ravotus/FaucetLED-pcb/README.md

# FaucetLED-pcb
PCB for the [FaucetLED](https://github.com/ravotus/FaucetLED) project.

Created with KiCad 4.0.5. Available through OSHPark: [https://oshpark.com/shared_projects/xyDQwA8Q](https://oshpark.com/shared_projects/xyDQwA8Q)
