ravotus/FaucetLED-pcb/FaucetLED.kicad_pcb

## KiCad design FaucetLED.kicad_pcb (2017-04-03)

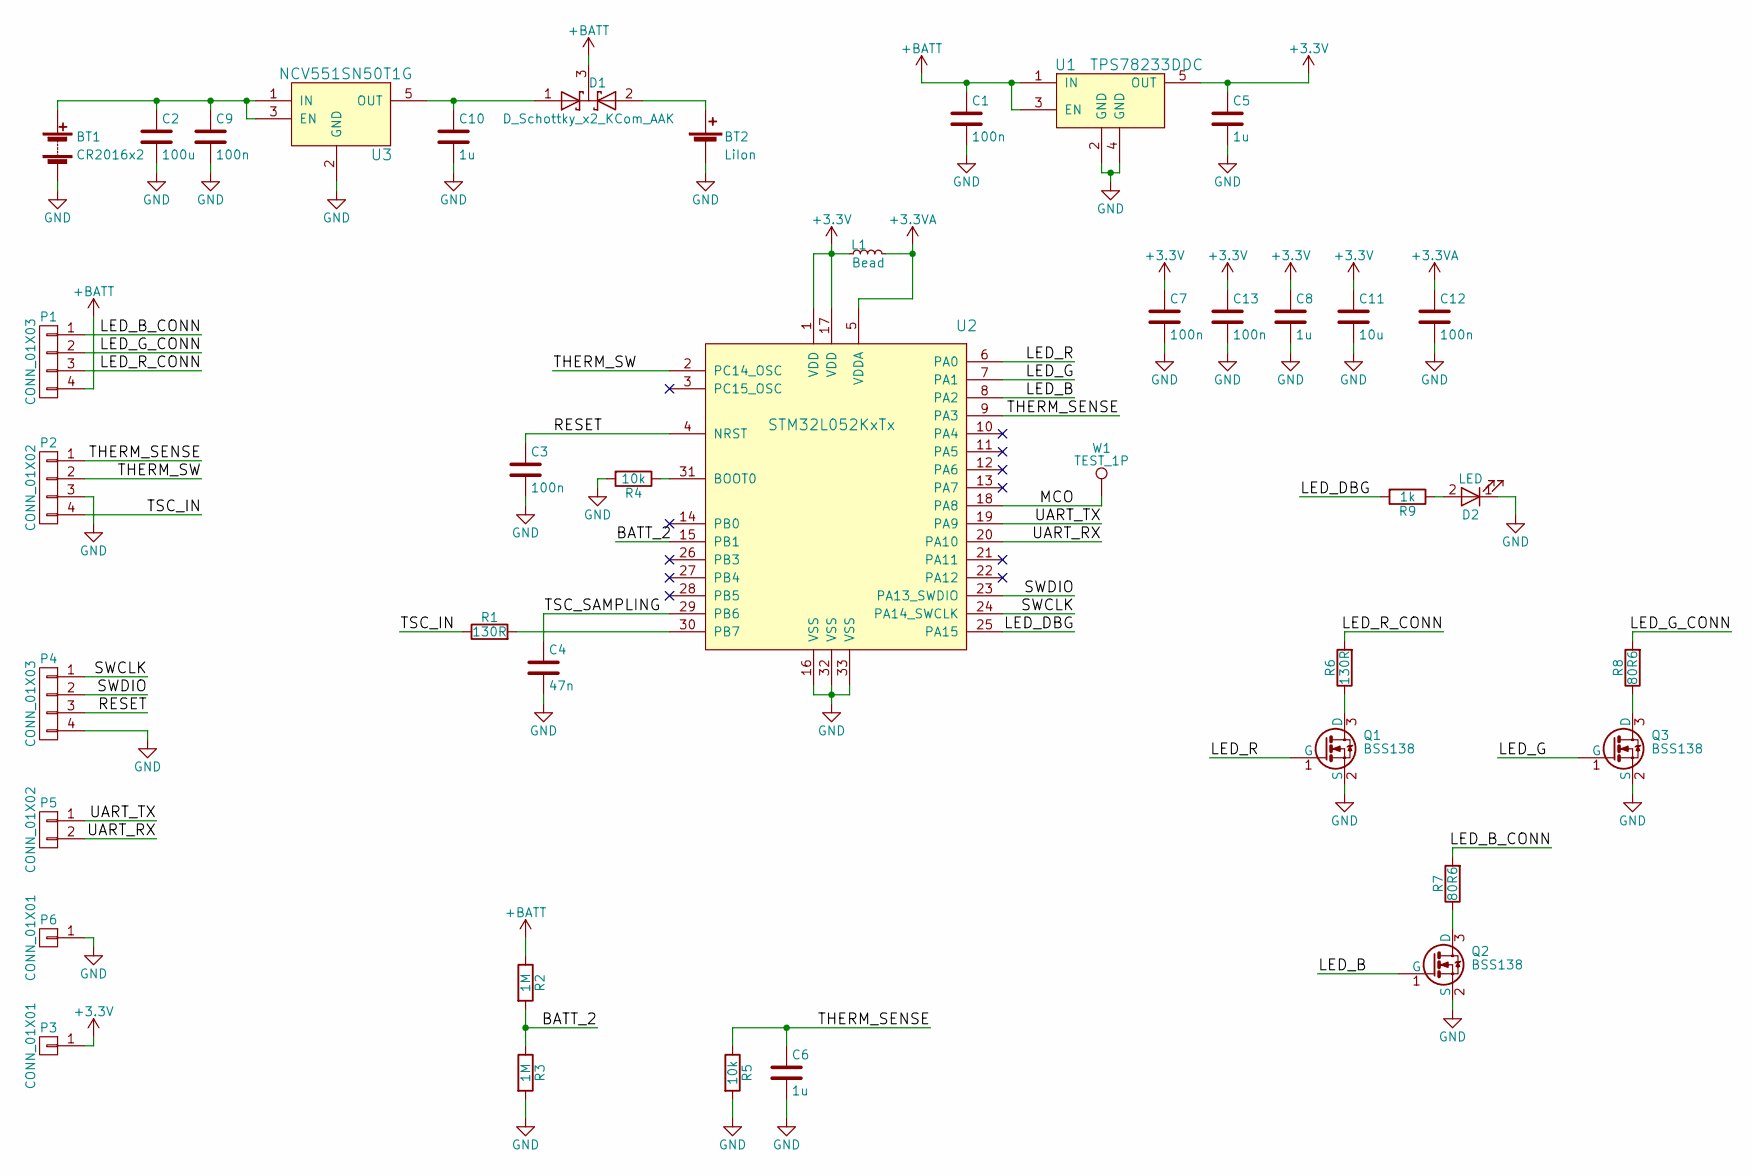
[picture p1: schematic FaucetLED.sch]

Parts:
BT1: CR2016x2; Keystone_3020_2x2016-CoinCell; Manufacturer PN 3020; DigiKey PN 36-3020-ND
BT2: LiIon; JST_PH_S2B-PH-K_02x2.00mm_Angled
C1, C3, C7, C9, C12, C13: 100n; C_0603
C2: 100u; C_1210; DigiKey PN 587-4313-1-ND
C4: 47n; C_0603_0805
C5, C8, C10: 1u; C_0603
C6: 1u; C_0603_0805
C11: 10u; C_0603; DigiKey PN 587-1256-1-ND
D1: D_Schottky_x2_KCom_AAK; SOT-23; Manufacturer PN TBAT54C; DigiKey PN TBAT54CLMCT-ND
D2: LED; LED_0805; DigiKey PN 67-2191-1-ND
L1: Bead; R_0603; Manufacturer PN BK1608HW601-T; DigiKey PN 587-1879-1-ND
P1: CONN_01X03; JST_PH_S4B-PH-K_04x2.00mm_Angled
P2: CONN_01X02; JST_PH_S4B-PH-K_04x2.00mm_Angled
P3, P6: CONN_01X01; Pin_Header_Straight_1x01_Pitch2.54mm
P4: CONN_01X03; Pin_Header_Straight_1x04_Pitch2.54mm
P5: CONN_01X02; Pin_Header_Straight_1x02_Pitch2.54mm
Q1, Q2, Q3: BSS138; SOT-23
R1, R6: 130R; R_0603_0805; DigiKey PN 311-130HRCT-ND
R2, R3: 1M; R_0603_0805; DigiKey PN 311-1.00MHRCT-ND
R4, R5: 10k; R_0603_0805
R7, R8: 80R6; R_0603_0805
R9: 1k; R_0603_0805
U1: TPS78233DDC; SOT-23-5
U2: STM32L052KxTx; LQFP-32_7x7mm_Pitch0.8mm_QFN-32-1EP_5x5mm_Pitch0.5mm-Combo; Manufacturer PN STM32L052K8T6; DigiKey PN 497-14904-ND
U3: NCV551SN50T1G; SOT-23-5
W1: TEST_1P; Measurement_Point_Round-SMD-Pad_Small

Connections:
+3.3VA: C12.1, L1.2, U2.5 (VDDA)
+3V3: C5.1, C7.1, C8.1, C11.1, C13.1, L1.1, P3.1, U1.5 (OUT), U2.1 (VDD), U2.17 (VDD)
+BATT: C1.1, D1.3 (K), P1.4, R2.1, U1.1 (IN), U1.3 (EN)
/BATT_2: R2.2, R3.1, U2.15 (PB1)
/LED_B: Q2.1 (G), U2.8 (PA2)
/LED_B_CONN: P1.1, R7.2
/LED_DBG: R9.2, U2.25 (PA15)
/LED_G: Q3.1 (G), U2.7 (PA1)
/LED_G_CONN: P1.2, R8.2
/LED_R: Q1.1 (G), U2.6 (PA0)
/LED_R_CONN: P1.3, R6.2
/MCO: U2.18 (PA8), W1.1
/RESET: C3.1, P4.3, U2.4 (NRST)
/SWCLK: P4.1, U2.24 (PA14_SWCLK)
/SWDIO: P4.2, U2.23 (PA13_SWDIO)
/THERM_SENSE: C6.1, P2.1, R5.1, U2.9 (PA3)
/THERM_SW: P2.2, U2.2 (PC14_OSC)
/TSC_IN: P2.4, R1.1
/TSC_SAMPLING: C4.1, U2.29 (PB6)
/UART_RX: P5.2, U2.20 (PA10)
/UART_TX: P5.1, U2.19 (PA9)
GND: BT1.2 (-), BT2.2 (-), C1.2, C2.2, C3.2, C4.2, C5.2, C6.2, C7.2, C8.2, C9.2, C10.2, C11.2, C12.2, C13.2, D2.1 (K), P2.3, P4.4, P6.1, Q1.2 (S), Q2.2 (S), Q3.2 (S), R3.2, R4.2, R5.2, U1.2 (GND), U1.4 (GND), U2.16 (VSS), U2.32 (VSS), U2.33 (VSS), U3.2 (GND)
unnamed: BT1.1 (+), C2.1, C9.1, U3.1 (IN), U3.3 (EN)
unnamed: BT2.1 (+), D1.2 (A)
unnamed: C10.1, D1.1 (A), U3.5 (OUT)
unnamed: D2.2 (A), R9.1
unnamed: Q1.3 (D), R6.1
unnamed: Q2.3 (D), R7.1
unnamed: Q3.3 (D), R8.1
unnamed: R1.2, U2.30 (PB7)
unnamed: R4.1, U2.31 (BOOT0)

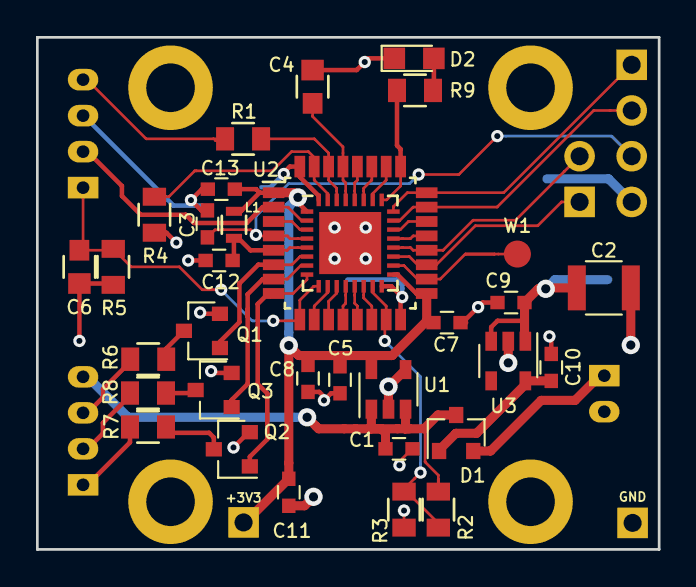
[picture p2: board FaucetLED.kicad_pcb from above]

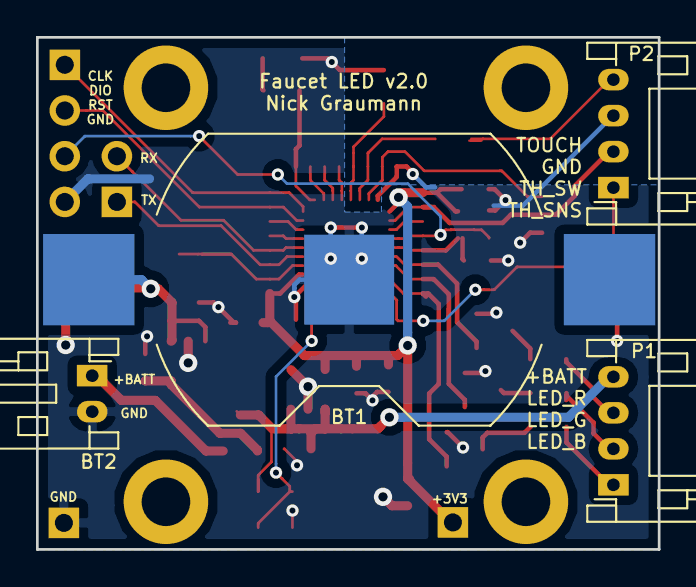
[picture p3: board FaucetLED.kicad_pcb from below]

Board: 2 copper layers, 34.5 x 28.4 mm, 40 parts (7 on the bottom side), 31 nets.
