ravotus/FaucetLED-pcb/(commit log)

2016-12-17 Add Kicad project with OSH Park design rules
    [FaucetLED.kicad_pcb, FaucetLED.sch]
2016-12-18 Faucet LED v1.0 PCB complete
    [FaucetLED.kicad_pcb]
2016-12-19 Minor PCB tweaks to allow easier modding for MAX4257 variant
    [FaucetLED.kicad_pcb]
2016-12-20 Rotate amplifier circuit so piezo is on right side
    [FaucetLED.kicad_pcb]
2016-12-20 Rotated amplifier another 90 degrees so piezo input is in the middle
    [FaucetLED.kicad_pcb]
2016-12-20 Swapped LED and thermistor pins on board
    [FaucetLED.kicad_pcb]
2016-12-20 Minor tweaks to spacing around amp circuit
    [FaucetLED.kicad_pcb]
2017-01-04 Add BOM generation.
    [FaucetLED-BOM.csv]
2017-02-20 WIP version 2 with STM32L0.
    [FaucetLED.kicad_pcb, FaucetLED.sch]
2017-02-20 Add battery holder, more connectors.
    [FaucetLED.kicad_pcb, FaucetLED.sch]
2017-02-20 Add part numbers for more parts.
    [FaucetLED.sch]
2017-02-21 Update R and C footprints for 0603/0805 compatibility.
    [FaucetLED.kicad_pcb, FaucetLED.sch]
2017-02-21 Add mounting holes for CU-18420-B enclosure.
    [FaucetLED.kicad_pcb]
2017-02-22 Add 5V regulator, LED drive NMOS. Not layed out in PCB yet.
    [FaucetLED.kicad_pcb, FaucetLED.sch]
2017-02-23 More schematic tweaks to resistor values.
    [FaucetLED.kicad_pcb, FaucetLED.sch]
2017-02-23 Rotate uC to 90deg again for ease of routing.
    [FaucetLED.kicad_pcb]
2017-02-23 First pass of PCB layout complete. Fixed a couple incorrect ADC pins.
    [FaucetLED.kicad_pcb, FaucetLED.sch]
2017-02-23 Fix paste on both sides issue of CR2016 footprint.
    [FaucetLED.kicad_pcb]
2017-02-23 Move connector silkscreens to bottom of board.
    [FaucetLED.kicad_pcb]
2017-02-23 Fix up silkscreens to avoid overlap.
    [FaucetLED.kicad_pcb]
2017-02-23 Add name and version to silkscreen.
    [FaucetLED.kicad_pcb]
2017-02-23 Change TSC resistor to 130R for commonality. Update BOM.
    [FaucetLED-BOM.csv, FaucetLED.sch]
2017-02-24 Fix some silkscreens for connectors.
    [FaucetLED.sch]
2017-02-25 Update to Kicad 4.0.5, re-import libraries.
    [FaucetLED.kicad_pcb, FaucetLED.sch]
2017-02-25 Remove rescue library from transition.
    [FaucetLED.sch]
2017-02-25 Fix coin cell holder to have GND pad in middle.
    [FaucetLED.kicad_pcb, FaucetLED.sch]
2017-02-25 Move uC up a bit for more room, increase center battery pad size.
    [FaucetLED.kicad_pcb]
2017-02-25 Add combo footprint for both QFN32 and LQFP32.
    [FaucetLED.kicad_pcb, FaucetLED.sch]
2017-02-25 Added more bypass caps.
    [FaucetLED.kicad_pcb, FaucetLED.sch]
2017-02-25 Move around caps for better layout.
    [FaucetLED.kicad_pcb]
2017-02-25 Restore accidentally deleted battery holder.
    [FaucetLED.kicad_pcb]
2017-02-25 Add additional bypass capacitor for other uC VCC pin.
    [FaucetLED.kicad_pcb, FaucetLED.sch]
2017-02-25 Make all bypass caps 0603, layout improvements to power and bypass.
    [FaucetLED.kicad_pcb, FaucetLED.sch]
2017-02-25 Reset cap was feeling squished, fix missing enable connection on +5V reg.
    [FaucetLED.kicad_pcb]
2017-02-25 Tweak position of C9 for rework, fix some silks.
    [FaucetLED.kicad_pcb]
2017-02-25 Add pin labels for headers, shrink all ref designators.
    [FaucetLED.kicad_pcb]
2017-02-25 Small schematic layout tweaks.
    [FaucetLED.sch]
2017-02-26 Move C3 closer to RESET pin on uC.
    [FaucetLED.kicad_pcb, FaucetLED.sch]
2017-02-26 Silkscreen position tweaks.
    [FaucetLED.kicad_pcb]
2017-02-26 Update BOM.
    [FaucetLED-BOM.csv, FaucetLED.sch]
2017-02-26 Move 100uF cap to battery input.
    [FaucetLED.kicad_pcb, FaucetLED.sch]
2017-02-26 Move BATT_2 sense R's closer to ADC input.
    [FaucetLED.kicad_pcb]
2017-02-26 Add footprint for another bulk cap C14 on +BATT.
    [FaucetLED.kicad_pcb, FaucetLED.sch]
2017-02-26 Change C2 and C14 to 1210 package for lower leakage.
    [FaucetLED.kicad_pcb, FaucetLED.sch]
2017-02-26 Slight move of C5 closer to 3.3V LDO.
    [FaucetLED.kicad_pcb, FaucetLED.sch]
2017-02-26 Make all 0.1uF caps 100nF, update some notes.
    [FaucetLED-BOM.csv, FaucetLED.kicad_pcb, FaucetLED.sch]
2017-02-27 Add some more Digikey part numbers.
    [FaucetLED-BOM.csv, FaucetLED.kicad_pcb, FaucetLED.sch]
2017-03-08 C4: Sampling capacitor: Change value to 0.1uF.
    [FaucetLED.kicad_pcb, FaucetLED.sch]
2017-03-08 Fix THERM_SENSE topology to form proper voltage divider.
    [FaucetLED.kicad_pcb, FaucetLED.sch]
2017-03-14 C4: Change sampling capacitor to 47nF.
    [FaucetLED-BOM.csv, FaucetLED.kicad_pcb, FaucetLED.sch]
2017-03-14 U1: Change to TPS782 3.3V regulator for lower Iq.
    [FaucetLED.kicad_pcb, FaucetLED.sch]
2017-03-14 C11: Change footprint to 0603 since 1206 was unnecessary.
    [FaucetLED-BOM.csv, FaucetLED.kicad_pcb, FaucetLED.sch]
2017-03-14 Remove C14 (extra 100uF) since testing showed it was unnecessary.
    [FaucetLED-BOM.csv, FaucetLED.kicad_pcb, FaucetLED.sch]
2017-03-14 Increase text size of connector silkscreen labels.
    [FaucetLED.kicad_pcb]
2017-04-03 C6: Change to 1uF for <50/60Hz cutoff freq.
    [FaucetLED.kicad_pcb, FaucetLED.sch]
2017-04-03 U1: Add Digikey PN.
    [FaucetLED-BOM.csv, FaucetLED.sch]
